Diabolocreep/Patrick-Parmentier-Robot-Precison-CMI3/README.md

On utilise des moteurs pas à pas -> Pa Pa -> "prénom commençant par Pa" + "nom commençant par Pa" -> Patrick Parmentier 

c'est son nom

Patrick Parmentier
