Diabolocreep/Patrick-Parmentier-Robot-Precison-CMI3/ModelsPiecesEtRobot/Projet Robot Precision/Roue libre/Wheel.SLDASM

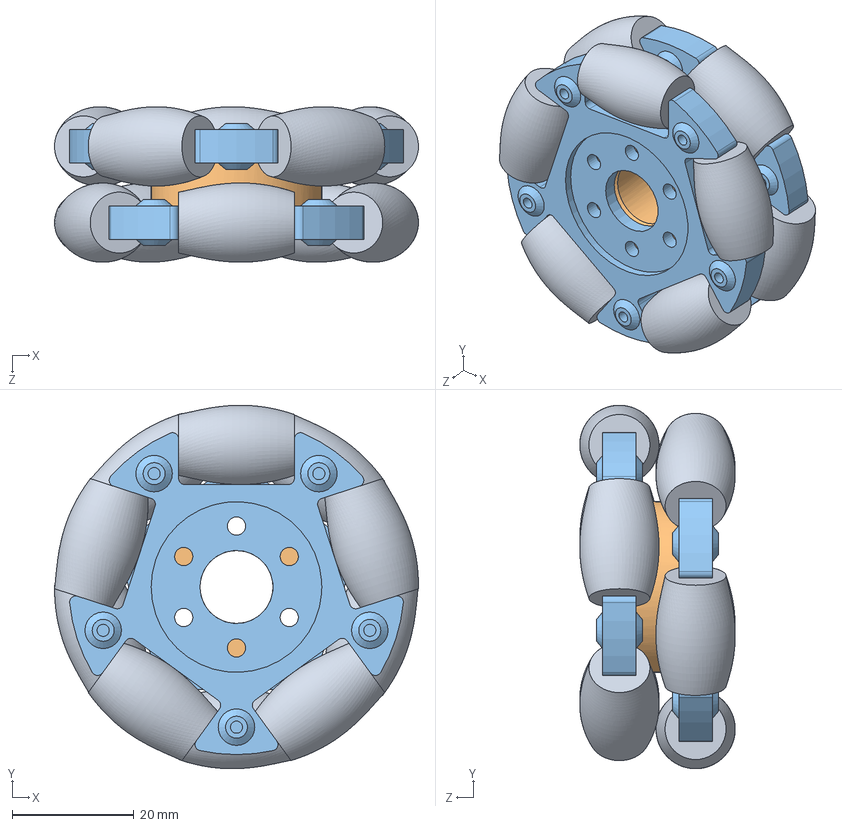
[picture p23: CAD file, 2026-04-10]
ModelsPiecesEtRobot/Projet Robot Precision/Roue libre/Wheel.SLDASM
59.7 x 59.6 x 25.5 mm
Alu_Base x 2
Middle_Plastic
Rubber x 10
