Diabolocreep/Patrick-Parmentier-Robot-Precison-CMI3/ModelsPiecesEtRobot/Projet Robot Precision/Moteur_pap.STEP

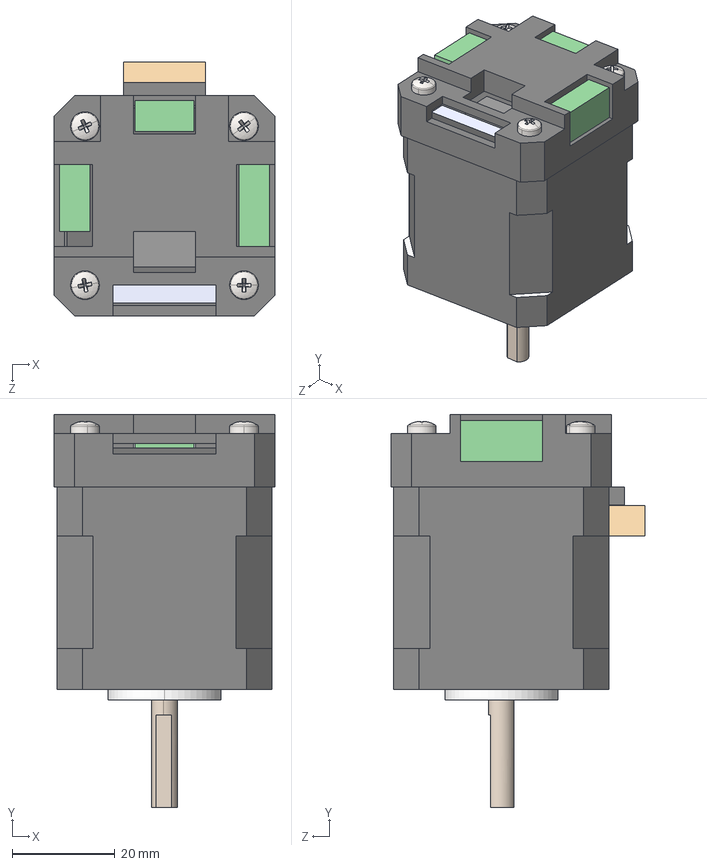
[picture p24: CAD file, 2026-04-10]
ModelsPiecesEtRobot/Projet Robot Precision/Moteur_pap.STEP
43.0 x 76.6 x 49.5 mm
42_Steeper
5mm-Shift_D-Shift
SERVO42D_PCB
SERVO42D
pan cross head_am_B18.6.7M - M3 x 0.5 x 30 Type I Cross Recessed PHMS --30N x 4
Space_7x3x3 x 4
