Diabolocreep/Patrick-Parmentier-Robot-Precison-CMI3/ModelsPiecesEtRobot/Projet Robot Precision/Roue libre/Wheel - Rubber-4.STL

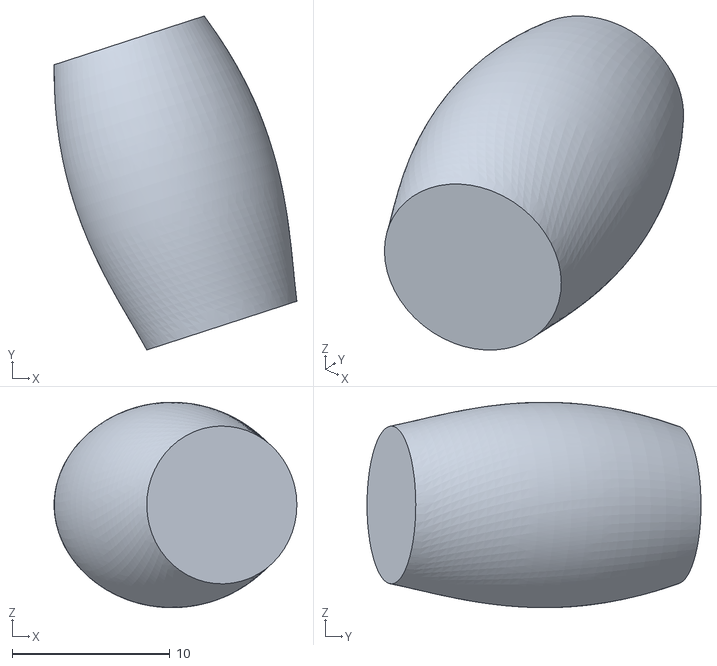
[picture p25: CAD file, 2026-04-10]
ModelsPiecesEtRobot/Projet Robot Precision/Roue libre/Wheel - Rubber-4.STL
15.4 x 21.2 x 13.0
