Diabolocreep/Patrick-Parmentier-Robot-Precison-CMI3/ModelsPiecesEtRobot/Projet Robot Precision/Roue libre/Middle_Plastic.SLDPRT

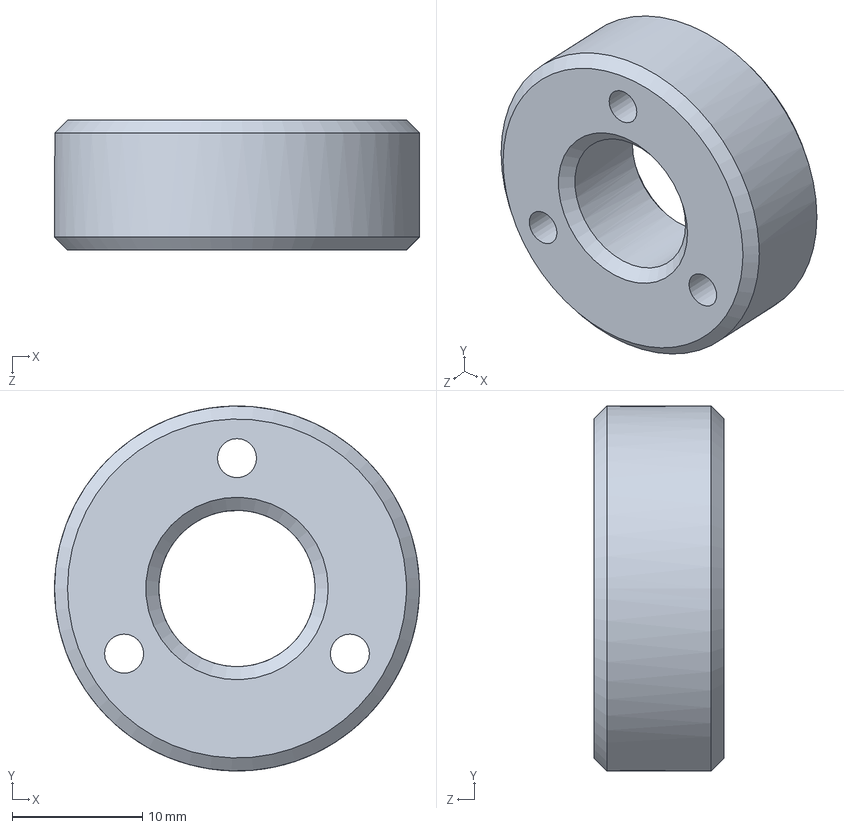
[picture p26: CAD file, 2026-04-10]
ModelsPiecesEtRobot/Projet Robot Precision/Roue libre/Middle_Plastic.SLDPRT
28.0 x 28.0 x 10.0 mm
