Diabolocreep/Patrick-Parmentier-Robot-Precison-CMI3/ModelsPiecesEtRobot/Projet Robot Precision/Support_moteur2.step

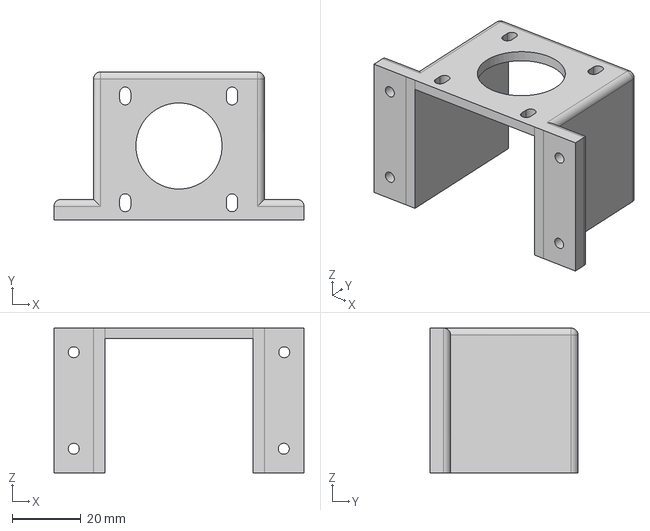
[picture p27: CAD file, 2026-04-10]
ModelsPiecesEtRobot/Projet Robot Precision/Support_moteur2.step
72.6 x 43.0 x 42.0 mm
