Diabolocreep/Patrick-Parmentier-Robot-Precison-CMI3/ModelsPiecesEtRobot/Projet Robot Precision/Roue libre/Rubber.SLDPRT

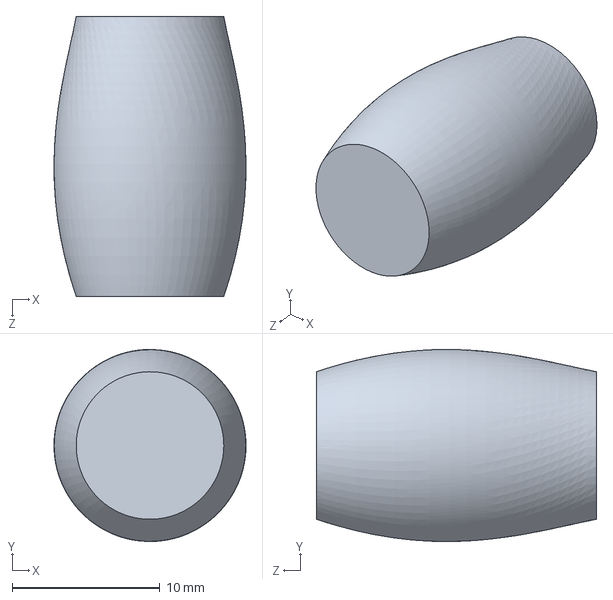
[picture p28: CAD file, 2026-04-10]
ModelsPiecesEtRobot/Projet Robot Precision/Roue libre/Rubber.SLDPRT
13.0 x 13.0 x 19.0 mm
