Diabolocreep/Patrick-Parmentier-Robot-Precison-CMI3/ModelsPiecesEtRobot/Projet Robot Precision/Support_interrupteur.SLDPRT

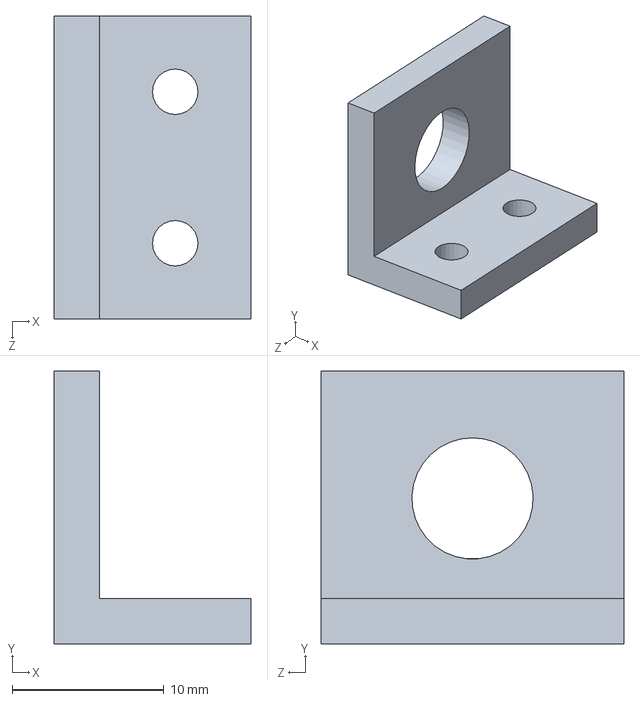
[picture p29: CAD file, 2026-04-10]
ModelsPiecesEtRobot/Projet Robot Precision/Support_interrupteur.SLDPRT
13.0 x 18.0 x 20.0 mm
