Diabolocreep/Patrick-Parmentier-Robot-Precison-CMI3/ModelsPiecesEtRobot/Projet Robot Precision/HRB Power 3300.step.SLDPRT

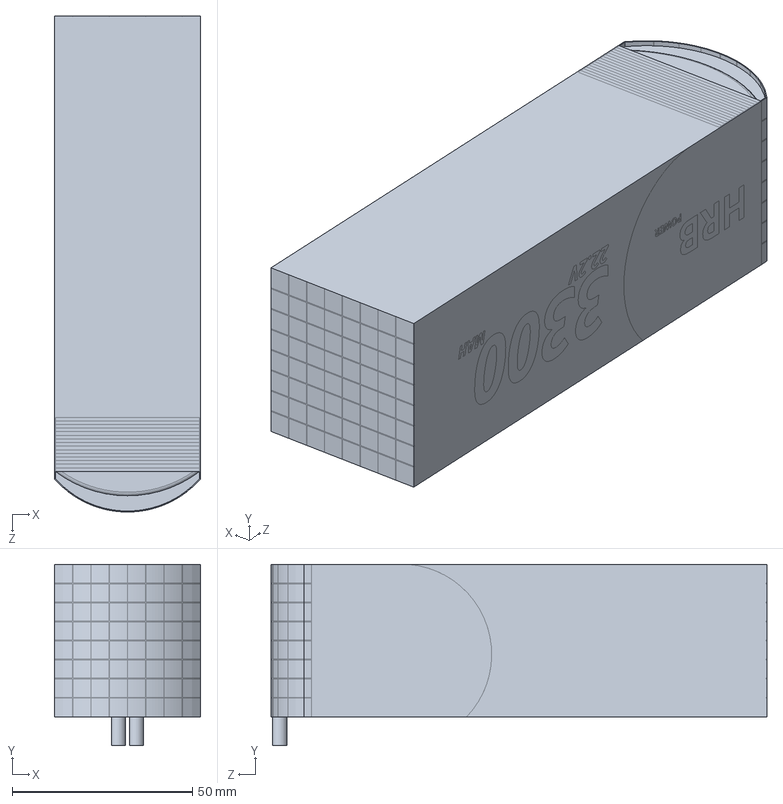
[picture p30: CAD file, 2026-04-10]
ModelsPiecesEtRobot/Projet Robot Precision/HRB Power 3300.step.SLDPRT
40.5 x 50.2 x 137.5 mm
