Diabolocreep/Patrick-Parmentier-Robot-Precison-CMI3/ModelsPiecesEtRobot/Projet Robot Precision/Roue libre/Wheel - Rubber-3.STL

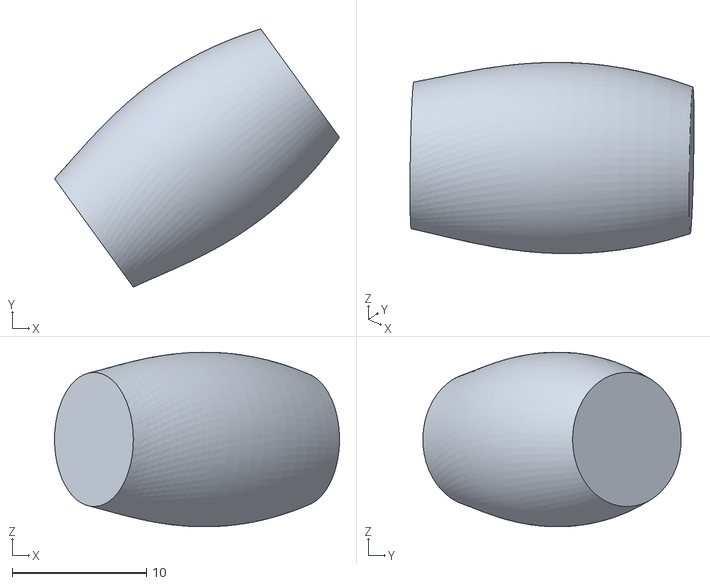
[picture p31: CAD file, 2026-04-10]
ModelsPiecesEtRobot/Projet Robot Precision/Roue libre/Wheel - Rubber-3.STL
21.2 x 19.3 x 13.0
