Diabolocreep/Patrick-Parmentier-Robot-Precison-CMI3/ModelsPiecesEtRobot/Projet Robot Precision/Interrupteur.step

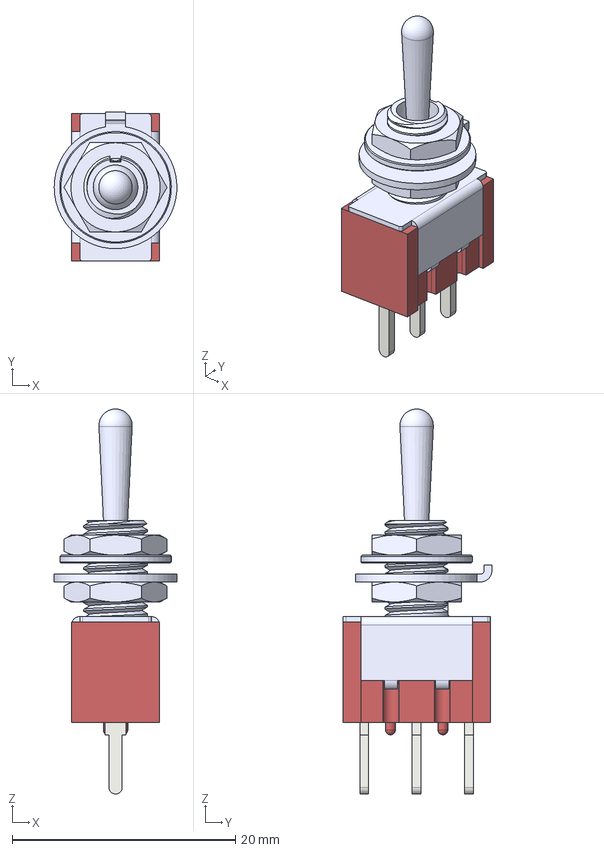
[picture p32: CAD file, 2026-04-10]
ModelsPiecesEtRobot/Projet Robot Precision/Interrupteur.step
11.0 x 13.4 x 34.5 mm
Washer Anti Twist Protection001
Nut M6x0.75mm 001
Nut M6x0.75mm clone001
Fantastic Plastic Body001
Neck001
Washer001
PCB PIN 002
PCB PIN clone 007
PCB PIN clone 008
Sheetmatal Frame001
Font O 004
Font N 003
Font - 003
Font O 005
Font F 003
Font F 004
Font - 004
Font O 006
Font N 004
Batton001
