Diabolocreep/Patrick-Parmentier-Robot-Precison-CMI3/ModelsPiecesEtRobot/Projet Robot Precision/Support_hall2.SLDPRT

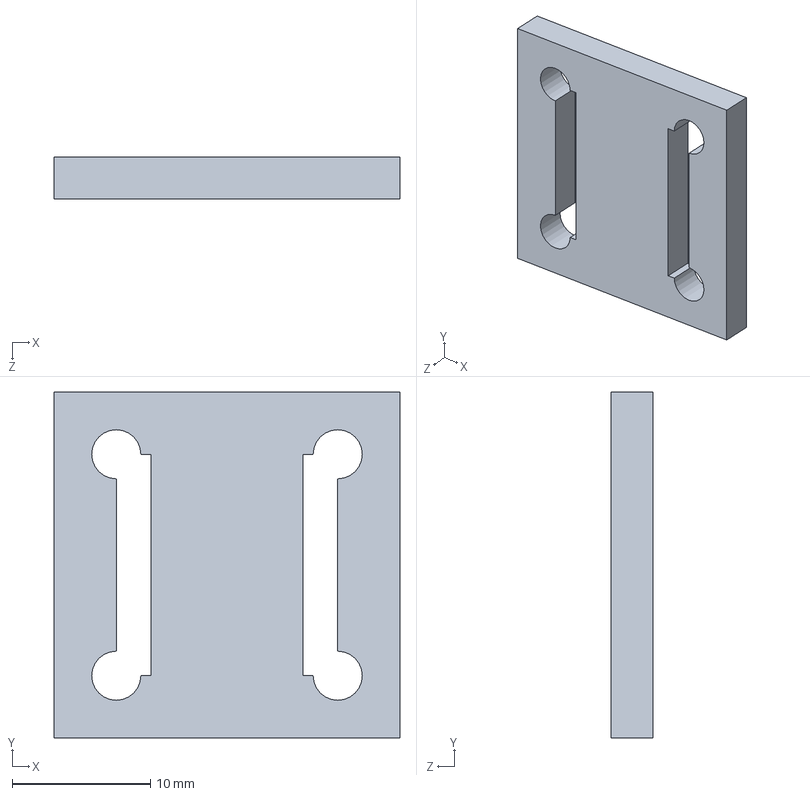
[picture p33: CAD file, 2026-04-10]
ModelsPiecesEtRobot/Projet Robot Precision/Support_hall2.SLDPRT
25.0 x 25.0 x 3.00 mm
