Diabolocreep/Patrick-Parmentier-Robot-Precison-CMI3/ModelsPiecesEtRobot/Projet Robot Precision/Roue libre/Alu_Base.SLDPRT

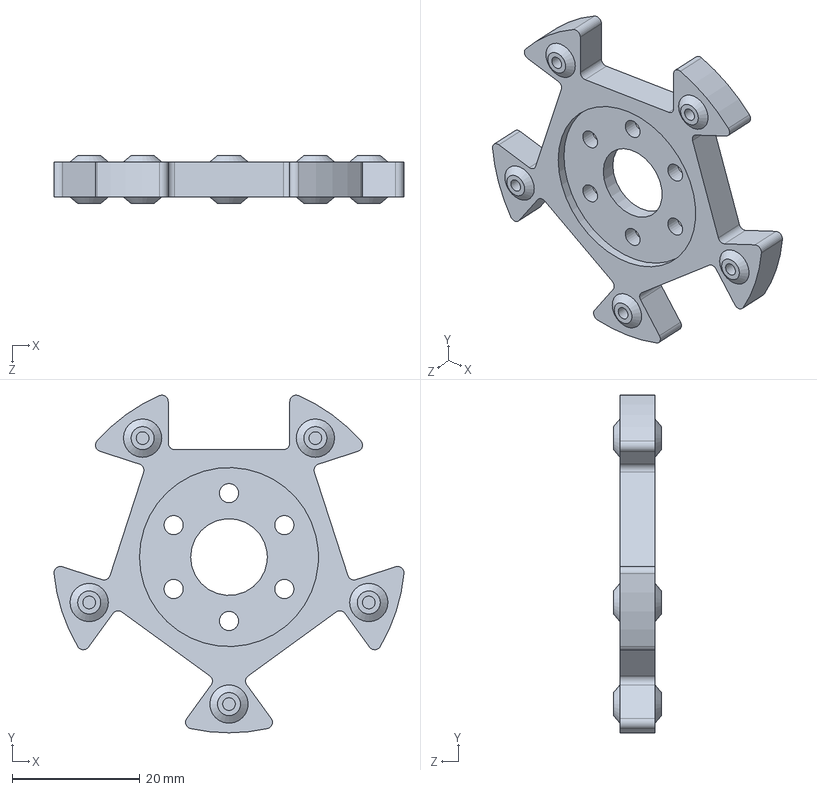
[picture p34: CAD file, 2026-04-10]
ModelsPiecesEtRobot/Projet Robot Precision/Roue libre/Alu_Base.SLDPRT
54.8 x 52.8 x 7.50 mm
