Diabolocreep/Patrick-Parmentier-Robot-Precison-CMI3/ModelsPiecesEtRobot/Projet Robot Precision/Support_hall.SLDPRT

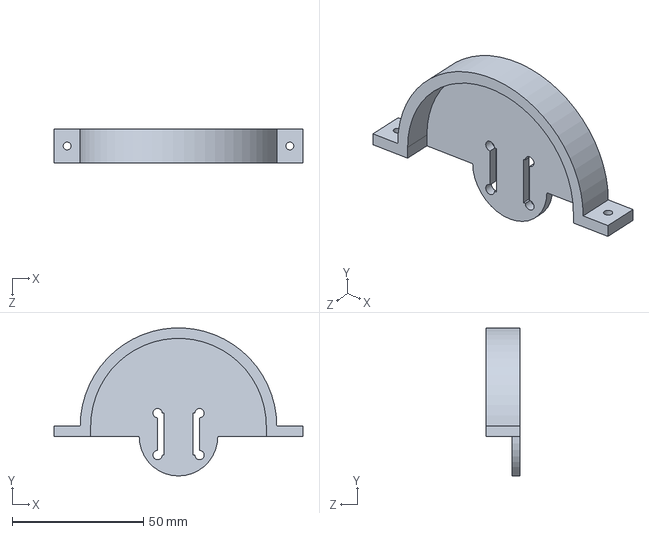
[picture p35: CAD file, 2026-04-10]
ModelsPiecesEtRobot/Projet Robot Precision/Support_hall.SLDPRT
95.0 x 56.4 x 13.0 mm
