Diabolocreep/Patrick-Parmentier-Robot-Precison-CMI3/ModelsPiecesEtRobot/Projet Robot Precision/Capteur_hall.step

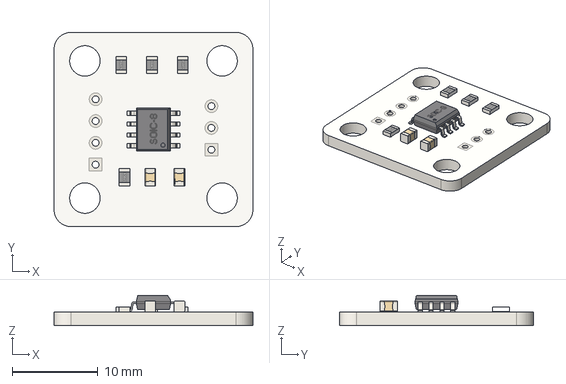
[picture p36: CAD file, 2026-04-10]
ModelsPiecesEtRobot/Projet Robot Precision/Capteur_hall.step
23.2 x 22.6 x 3.50 mm
