Diabolocreep/Patrick-Parmentier-Robot-Precison-CMI3/ModelsPiecesEtRobot/Projet Robot Precision/Axe_roue_libre.SLDPRT

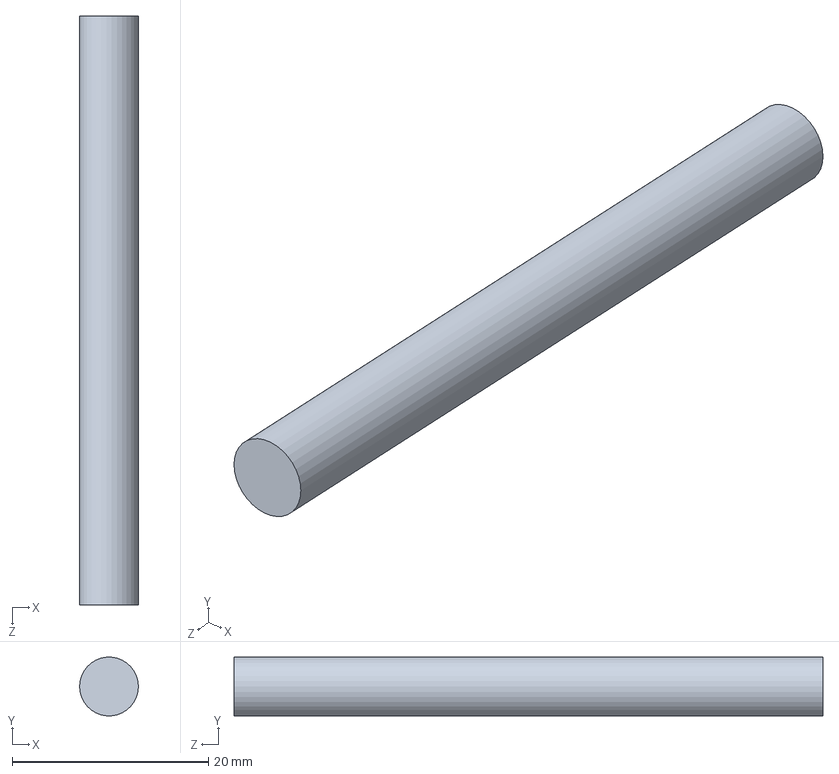
[picture p37: CAD file, 2026-04-10]
ModelsPiecesEtRobot/Projet Robot Precision/Axe_roue_libre.SLDPRT
6.00 x 5.97 x 60.0 mm
