Diabolocreep/Patrick-Parmentier-Robot-Precison-CMI3/ModelsPiecesEtRobot/Projet Robot Precision/Support_roulement.SLDPRT

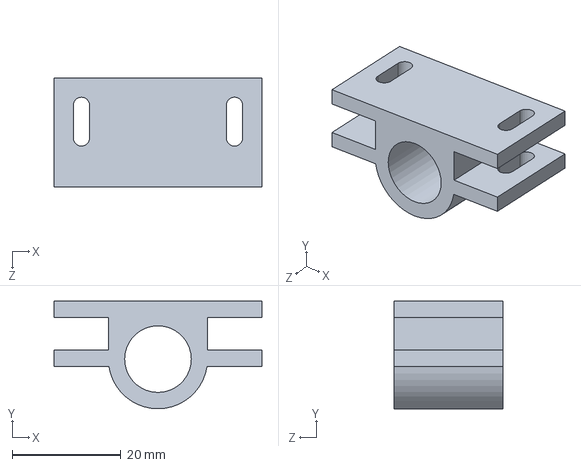
[picture p38: CAD file, 2026-04-10]
ModelsPiecesEtRobot/Projet Robot Precision/Support_roulement.SLDPRT
38.2 x 19.8 x 20.0 mm
