Diabolocreep/Patrick-Parmentier-Robot-Precison-CMI3/ModelsPiecesEtRobot/Projet Robot Precision/Chassi.SLDPRT

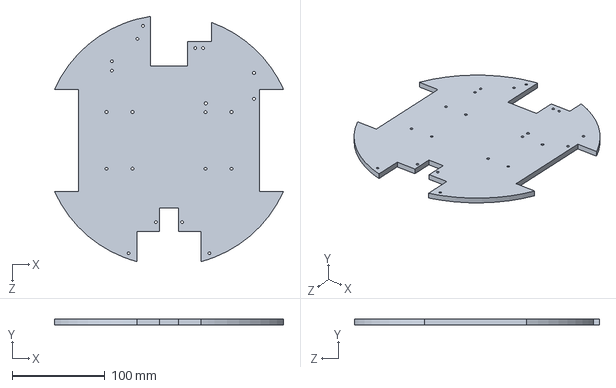
[picture p39: CAD file, 2026-04-10]
ModelsPiecesEtRobot/Projet Robot Precision/Chassi.SLDPRT
246.6 x 6.00 x 264.0 mm
