Diabolocreep/Patrick-Parmentier-Robot-Precison-CMI3/ModelsPiecesEtRobot/Projet Robot Precision/Support_roulement2.SLDPRT

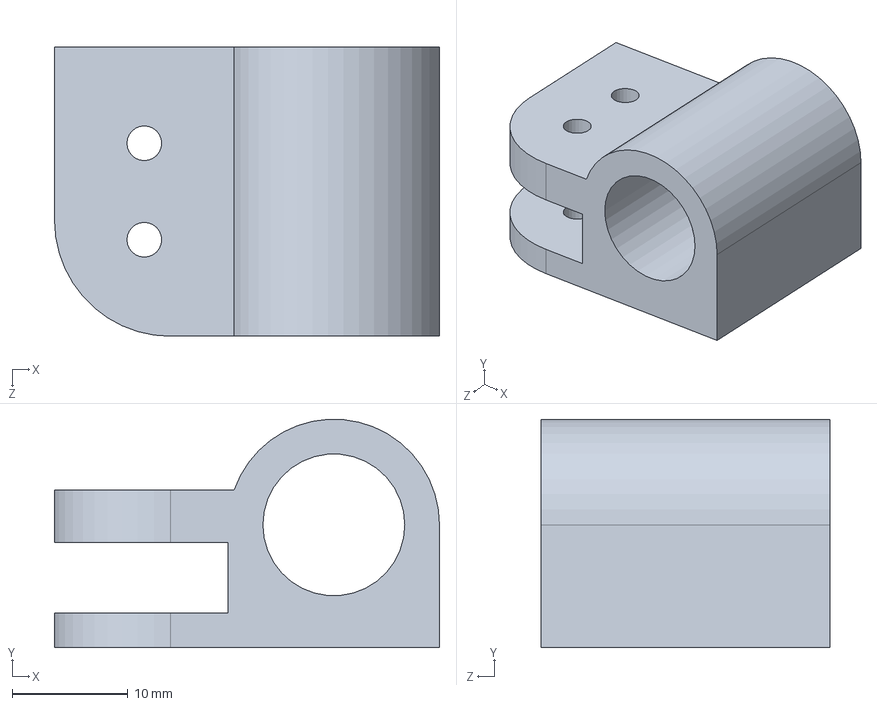
[picture p40: CAD file, 2026-04-10]
ModelsPiecesEtRobot/Projet Robot Precision/Support_roulement2.SLDPRT
33.2 x 19.7 x 25.0 mm
