Diabolocreep/Patrick-Parmentier-Robot-Precison-CMI3/ModelsPiecesEtRobot/Projet Robot Precision/Aimant.SLDPRT

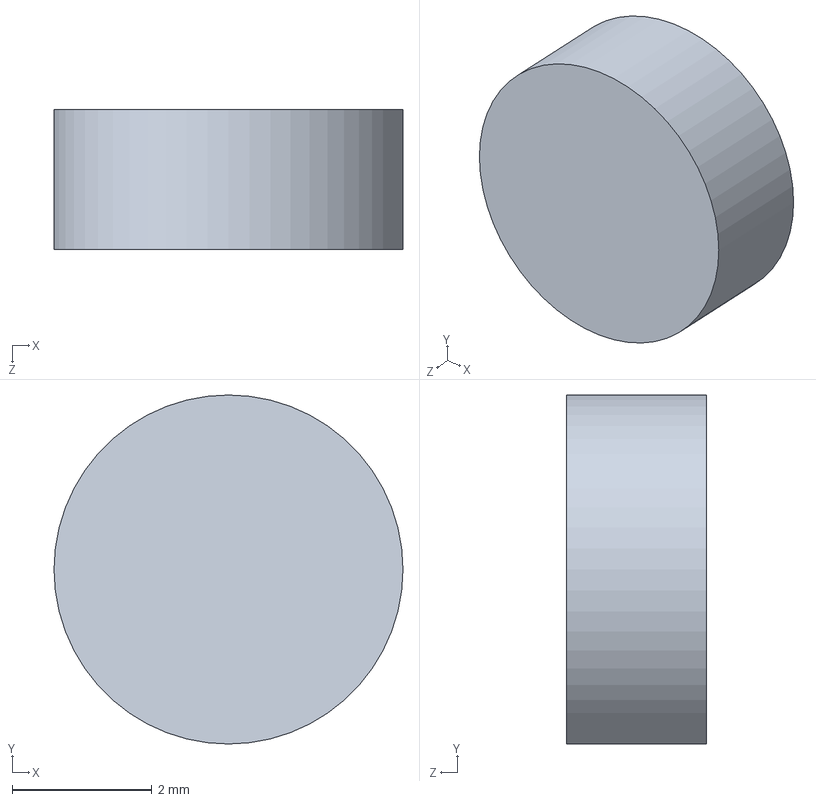
[picture p41: CAD file, 2026-04-10]
ModelsPiecesEtRobot/Projet Robot Precision/Aimant.SLDPRT
5.00 x 5.00 x 2.00 mm
