Diabolocreep/Patrick-Parmentier-Robot-Precison-CMI3/ModelsPiecesEtRobot/Projet Robot Precision/Roue_motorisee.SLDPRT

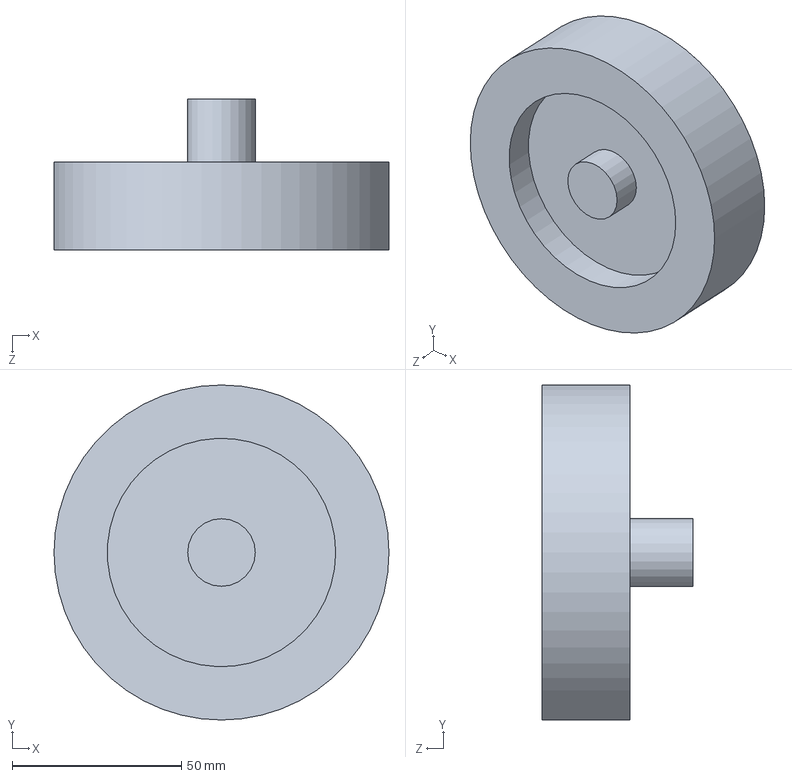
[picture p42: CAD file, 2026-04-10]
ModelsPiecesEtRobot/Projet Robot Precision/Roue_motorisee.SLDPRT
99.0 x 99.0 x 44.5 mm
