Diabolocreep/Patrick-Parmentier-Robot-Precison-CMI3/ModelsPiecesEtRobot/Projet Robot Precision/disque_aimant.SLDPRT

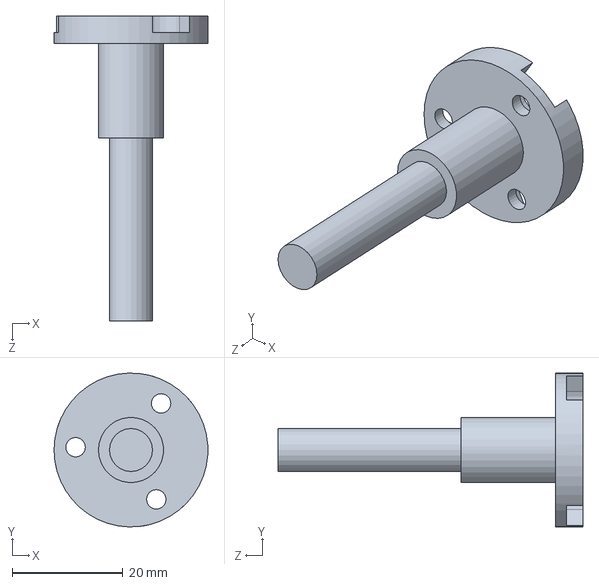
[picture p43: CAD file, 2026-04-10]
ModelsPiecesEtRobot/Projet Robot Precision/disque_aimant.SLDPRT
27.8 x 27.7 x 55.0 mm
