Diabolocreep/Patrick-Parmentier-Robot-Precison-CMI3/ModelsPiecesEtRobot/Projet Robot Precision/Roulement_bille.SLDPRT

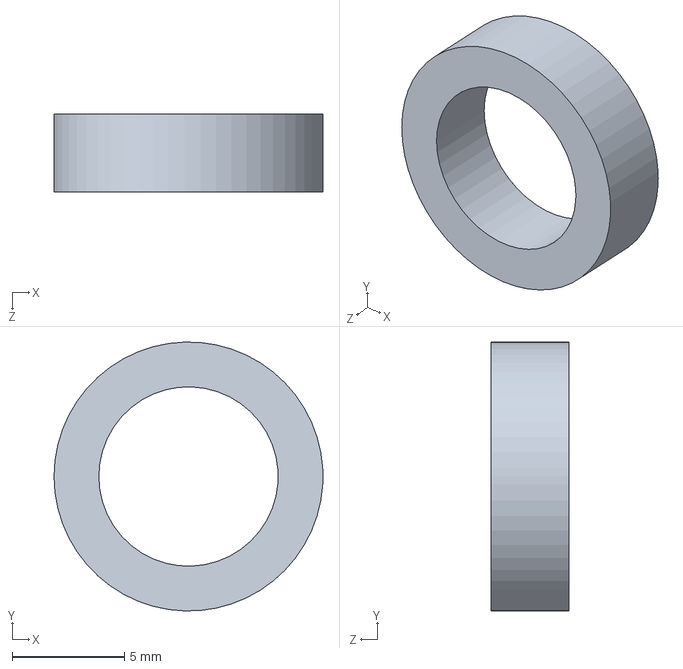
[picture p44: CAD file, 2026-04-10]
ModelsPiecesEtRobot/Projet Robot Precision/Roulement_bille.SLDPRT
12.0 x 12.0 x 3.50 mm
