Diabolocreep/Patrick-Parmentier-Robot-Precison-CMI3/ModelsPiecesEtRobot/Projet Robot Precision/Arduino.SLDPRT

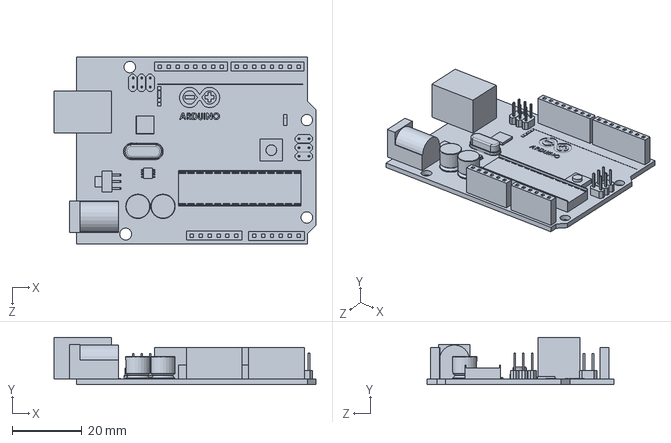
[picture p45: CAD file, 2026-04-10]
ModelsPiecesEtRobot/Projet Robot Precision/Arduino.SLDPRT
75.1 x 13.6 x 53.5 mm
