Diabolocreep/Patrick-Parmentier-Robot-Precison-CMI3/(list of files, cad)

Other CAD files:
ModelsPiecesEtRobot/Projet Robot Precision/Roue libre/Wheel - Rubber-10.STL
ModelsPiecesEtRobot/Projet Robot Precision/Roue libre/Wheel - Rubber-5.STL
ModelsPiecesEtRobot/Projet Robot Precision/Roue libre/Wheel - Rubber-6.STL
ModelsPiecesEtRobot/Projet Robot Precision/Roue libre/Wheel - Rubber-7.STL
ModelsPiecesEtRobot/Projet Robot Precision/Roue libre/Wheel - Rubber-1.STL
ModelsPiecesEtRobot/Projet Robot Precision/Roue libre/Wheel - Rubber-8.STL
ModelsPiecesEtRobot/Projet Robot Precision/Roue libre/Wheel - Middle_Plastic-1.STL
ModelsPiecesEtRobot/Projet Robot Precision/Roue libre/Wheel - Rubber-9.STL
ModelsPiecesEtRobot/Projet Robot Precision/Batterie.step
ModelsPiecesEtRobot/Projet Robot Precision/Roue libre/Wheel - Alu_Base-2.STL
ModelsPiecesEtRobot/Projet Robot Precision/Roue libre/Wheel - Alu_Base-1.STL
ModelsPiecesEtRobot/Projet Robot Precision/Roue libre/Wheel - Rubber-2.STL
ModelsPiecesEtRobot/Projet Robot Precision/batterie.SLDPRT
