Diabolocreep/Patrick-Parmentier-Robot-Precison-CMI3/programs/cmde_vit_broadcast/cmde_vit_broadcast.ino

#define RXD2 16
#define TXD2 17

uint8_t txBuffer[20];

uint16_t runSpeed = 0;
uint8_t runDir = 0;
uint8_t sAddr = 0;  // adresse 0 = broadcast
uint8_t accel = 0;
uint8_t emStop = 0;

uint8_t getCheckSum(uint8_t *buffer, uint8_t len);
void speedModeRun(uint8_t slaveAddr, uint8_t dir, uint16_t speed, uint8_t acc);

void setup() {
  pinMode(LED_BUILTIN, OUTPUT);
  digitalWrite(LED_BUILTIN, LOW);

  Serial.begin(38400);                           // sniff USB
  Serial2.begin(38400, SERIAL_8N1, RXD2, TXD2);  // bus moteurs

  delay(3000);

  Serial.println("Choose the running motor : RIGHT = 1 | LEFT = 2 | ALL = 0");
  while (Serial.available() == 0)
    ;                                            //attend une entrée
  sAddr = Serial.parseInt();                     //recupere l'entrée du serial monitor
  while (Serial.available() > 0) Serial.read();  //vide le Serial.available()

  Serial.println("Choose the direction : FORWARD = 0 | BACKWARD = 1");
  while (Serial.available() == 0)
    ;
  runDir = Serial.parseInt();
  while (Serial.available() > 0) Serial.read();

  Serial.println("Choose the speed : 0-3000");
  while (Serial.available() == 0)
    ;
  runSpeed = Serial.parseInt();
  while (Serial.available() > 0) Serial.read();

  Serial.println("Choose the acceleration : 0-255");
  while (Serial.available() == 0)
    ;
  accel = Serial.parseInt();
  while (Serial.available() > 0) Serial.read();
}

void loop() {
  if (emStop == 1) {
    stopComm();
  } else {
    speedModeRun(sAddr, runDir, runSpeed, accel);  // STEEL BALL RUN
    digitalWrite(LED_BUILTIN, digitalRead(LED_BUILTIN) ^ 1);
  }
  /*-------------- test allers retours
  runSpeed += 100;

  if(runSpeed > 300)
  {
    runSpeed = 0;
    runDir ^= 1;
  }
*/
  while (Serial.available() == 0);
  emStop = Serial.parseInt();
  while (Serial.available() > 0) Serial.read();

  delay(3000);
}


/*--------------------------------*/
/* Commande vitesse mode broadcast*/
/*--------------------------------*/

void speedModeRun(uint8_t slaveAddr, uint8_t dir, uint16_t speed, uint8_t acc)  //speed : 1-3000 , dir : 0-1, acc : 0-255
{
  //-----------------------------------------
  txBuffer[0] = 0xFA;                                // header
  txBuffer[1] = slaveAddr;                           // adresse (0 = broadcast)
  txBuffer[2] = 0xF6;                                // fonction speed mode
  txBuffer[3] = (dir << 7) | ((speed >> 8) & 0x0F);  //le dernier bit est la direction et les 4 premiers sont la vitesse (avec le 5eme octet)
  txBuffer[4] = speed & 0xFF;                        // vitesse (avec les 4 premiers bits de l'octet 4)
  txBuffer[5] = acc;                                 //acceleration 0-255
  txBuffer[6] = getCheckSum(txBuffer, 6);
  //-----------------------------------------

  Serial.print("TX : ");

  for (int i = 0; i < 7; i++) {
    Serial.printf("%02X ", txBuffer[i]);
  }

  Serial.println();

  Serial2.write(txBuffer, 7);
}

void moveModeRun(uint8_t slaveAddr, uint8_t dir, uint16_t speed, uint8_t acc)  //speed : 1-3000 , dir : 0-1, acc : 0-255
{
  //-----------------------------------------
  txBuffer[0] = 0xFA;                                // header
  txBuffer[1] = slaveAddr;                           // adresse (0 = broadcast)
  txBuffer[2] = 0xF6;                                // fonction speed mode
  txBuffer[3] = (dir << 7) | ((speed >> 8) & 0x0F);  //le dernier bit est la direction et les 4 premiers sont la vitesse (avec le 5eme octet)
  txBuffer[4] = speed & 0xFF;                        // vitesse (avec les 4 premiers bits de l'octet 4)
  txBuffer[5] = acc;                                 //acceleration 0-255
  txBuffer[6] = getCheckSum(txBuffer, 6);
  //-----------------------------------------

  Serial.print("TX : ");

  for (int i = 0; i < 7; i++) {
    Serial.printf("%02X ", txBuffer[i]);
  }

  Serial.println();

  Serial2.write(txBuffer, 7);
}

void stopComm() {
  //-----------------------------------------
  txBuffer[0] = 0xFA;
  txBuffer[1] = 0;
  txBuffer[2] = 0xF6;
  txBuffer[3] = 0;
  txBuffer[4] = 0;
  txBuffer[5] = 2;  //si acc = 0 les moteurs s'arretent immédiatement, en mettant 4 ils vont décélérer d'abord
  txBuffer[6] = getCheckSum(txBuffer, 6);
  //-----------------------------------------

  Serial.print("TX : ");

  for (int i = 0; i < 7; i++) {
    Serial.printf("%02X ", txBuffer[i]);
  }

  Serial.println();

  Serial2.write(txBuffer, 7);
}

/*---------------------------*/
/* Calcul checksum           */
/*---------------------------*/

uint8_t getCheckSum(uint8_t *buffer, uint8_t size) {
  uint16_t sum = 0;

  for (uint8_t i = 0; i < size; i++) {
    sum += buffer[i];
  }

  return (sum & 0xFF);
}
