Diabolocreep/Patrick-Parmentier-Robot-Precison-CMI3/(commit log)

2026-04-10 added files
    Ajout des différents fichiers concernant le projet.
2026-04-10 adding files
    Ajout des models 3D.
2026-04-10 rapport
    Ajout du rapport de projet.
2026-04-10 added non zip version of files
    Ajout des fichiers non compréssés.
    [Aimant.SLDPRT, Alu_Base.SLDPRT, Arduino.SLDPRT, Axe_roue_libre.SLDPRT, Batterie.step, Capteur_hall.step, Chassi.SLDPRT, HRB Power 3300.step.SLDPRT]
2026-04-13 modified program
    V1_3 -> le robot ne peut plus faire de rotation, mais le systeme de file marche mieux
